UCI-Rocket-Project/rocket2-load-cell/rocket2-load-cell_render.jpg

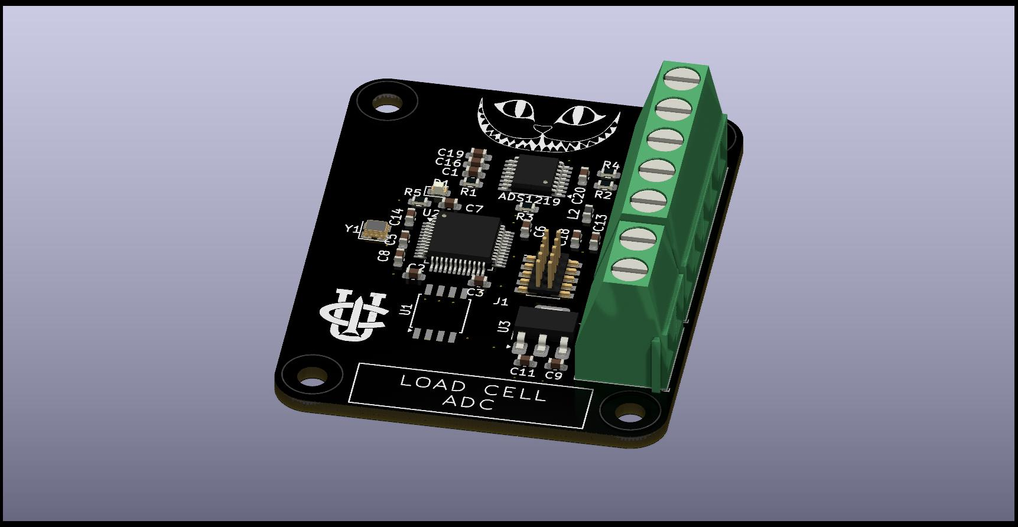
rocket2-load-cell_render.jpg
