UCI-Rocket-Project/rocket2-load-cell/topdown.png

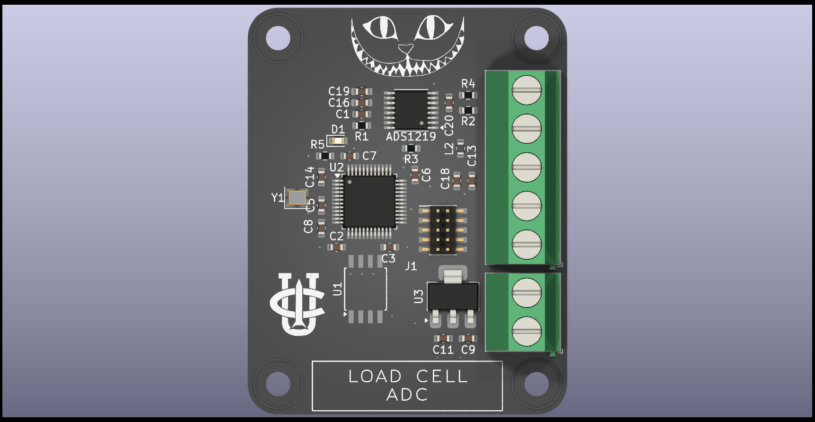
topdown.png
