UCI-Rocket-Project/rocket2-load-cell/chesirecat_image.jpg

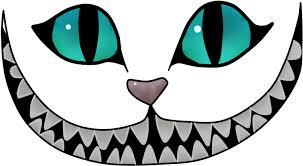
chesirecat_image.jpg
