UCI-Rocket-Project/rocket2-load-cell/side.png

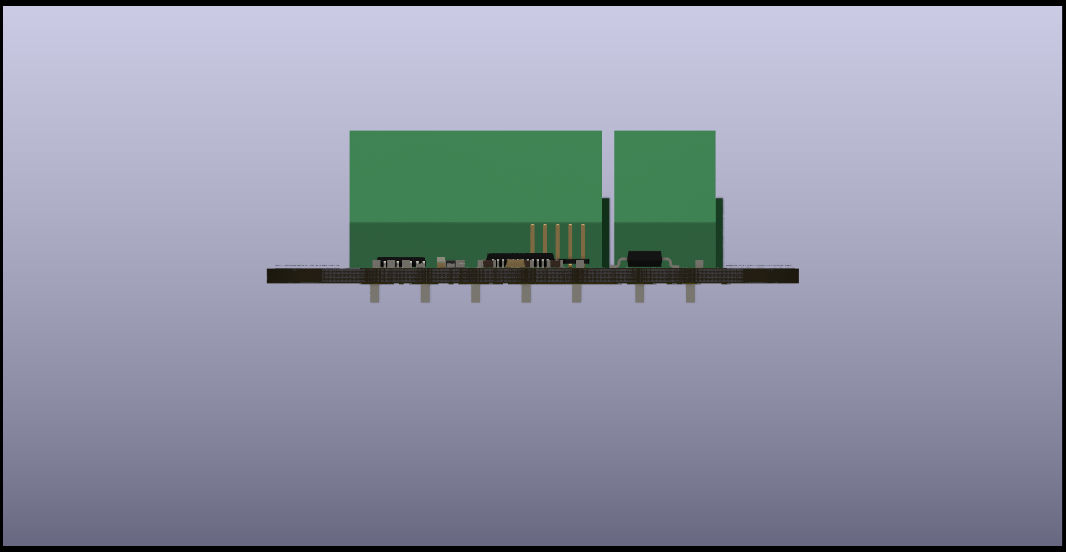
side.png
