UCI-Rocket-Project/rocket2-load-cell/3d/XPort assembly.stp

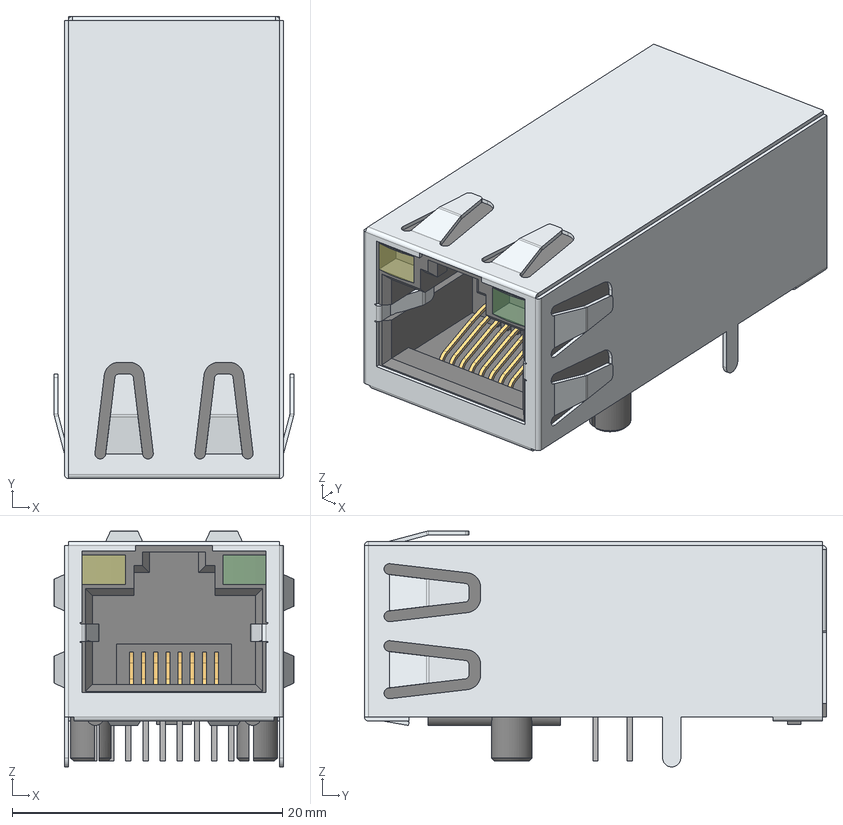
[picture p5: CAD file, 2025-01-15]
3d/XPort assembly.stp
17.7 x 34.2 x 17.5 mm
XPort Part1
XPort Part2 x 8
XPort Part6 x 9
XPort Part5
XPort part4
XPort Part3
XPort Part8
XPort Part7
