UCI-Rocket-Project/rocket2-load-cell/3d/GX12.stp

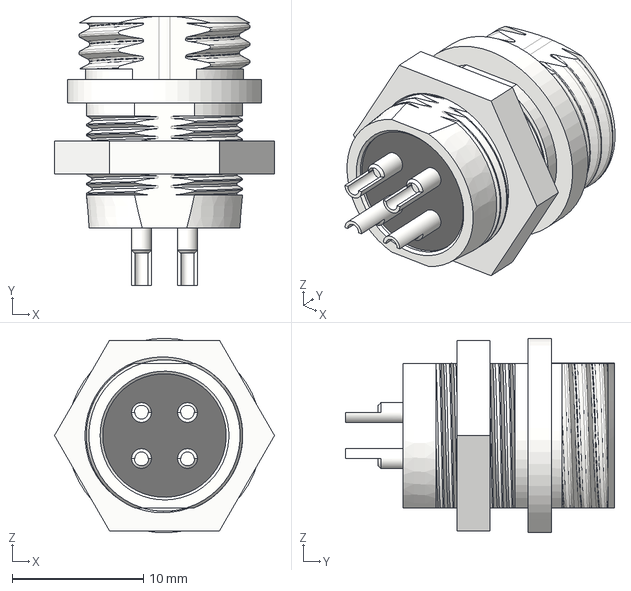
[picture p6: CAD file, 2025-01-15]
3d/GX12.stp
16.7 x 20.5 x 14.8 mm
