UCI-Rocket-Project/rocket2-load-cell/freecadpcb.FCStd

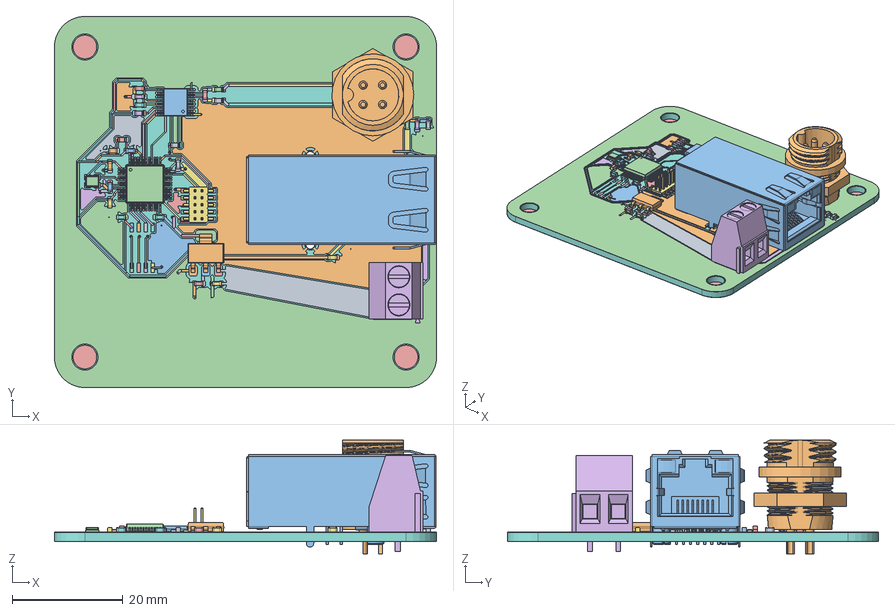
[picture p7: CAD file, 2025-05-16]
freecadpcb.FCStd
69.0 x 67.0 x 20.5 mm
R_0603_1608Metric
R_0603_1608Metric002
XPort assembly
LQFP_48_7x7mm_P05mm
C_0603_1608Metric
R_0603_1608Metric004
C_0603_1608Metric002
C_0603_1608Metric004
R_0603_1608Metric006
SOT_223
TSSOP_16_44x5mm_P065mm
Crystal_SMD_2520-4Pin_2.5x2.0mm
LED_0603_1608Metric
TerminalBlock_Phoenix_MKDS_15_2_508_1x02_P508mm_Horizontal
PinHeader_2x05_P127mm_Vertical_SMD
C_0603_1608Metric006
C_0603_1608Metric008
C_0603_1608Metric010
C_0603_1608Metric012
L_0603_1608Metric
C_0603_1608Metric014
C_0603_1608Metric016
C_0603_1608Metric018
C_0603_1608Metric020
C_0603_1608Metric022
GX12 v2
C_0603_1608Metric024
R_0603_1608Metric008
C_0603_1608Metric026
C_0603_1608Metric028
C_0603_1608Metric030
rocket2-load-cell_track_1
rocket2-load-cell_track_2
rocket2-load-cell_track_3
rocket2-load-cell_track_4
rocket2-load-cell_track_5
rocket2-load-cell_track_6
rocket2-load-cell_track_7
rocket2-load-cell_track_8
rocket2-load-cell_track_9
rocket2-load-cell_track_10
rocket2-load-cell_track_11
rocket2-load-cell_track_12
rocket2-load-cell_track_13
rocket2-load-cell_track_14
rocket2-load-cell_track_15
rocket2-load-cell_track_16
rocket2-load-cell_track_17
rocket2-load-cell_track_18
rocket2-load-cell_track_19
rocket2-load-cell_track_20
rocket2-load-cell_track_21
rocket2-load-cell_track_22
rocket2-load-cell_track_23
rocket2-load-cell_track_24
rocket2-load-cell_track_25
rocket2-load-cell_track_26
rocket2-load-cell_track_27
rocket2-load-cell_track_28
rocket2-load-cell_track_29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
