UCI-Rocket-Project/rocket2-load-cell/rocket2-load-cell.kicad_pcb

## KiCad design rocket2-load-cell.kicad_pcb (2025-05-16)

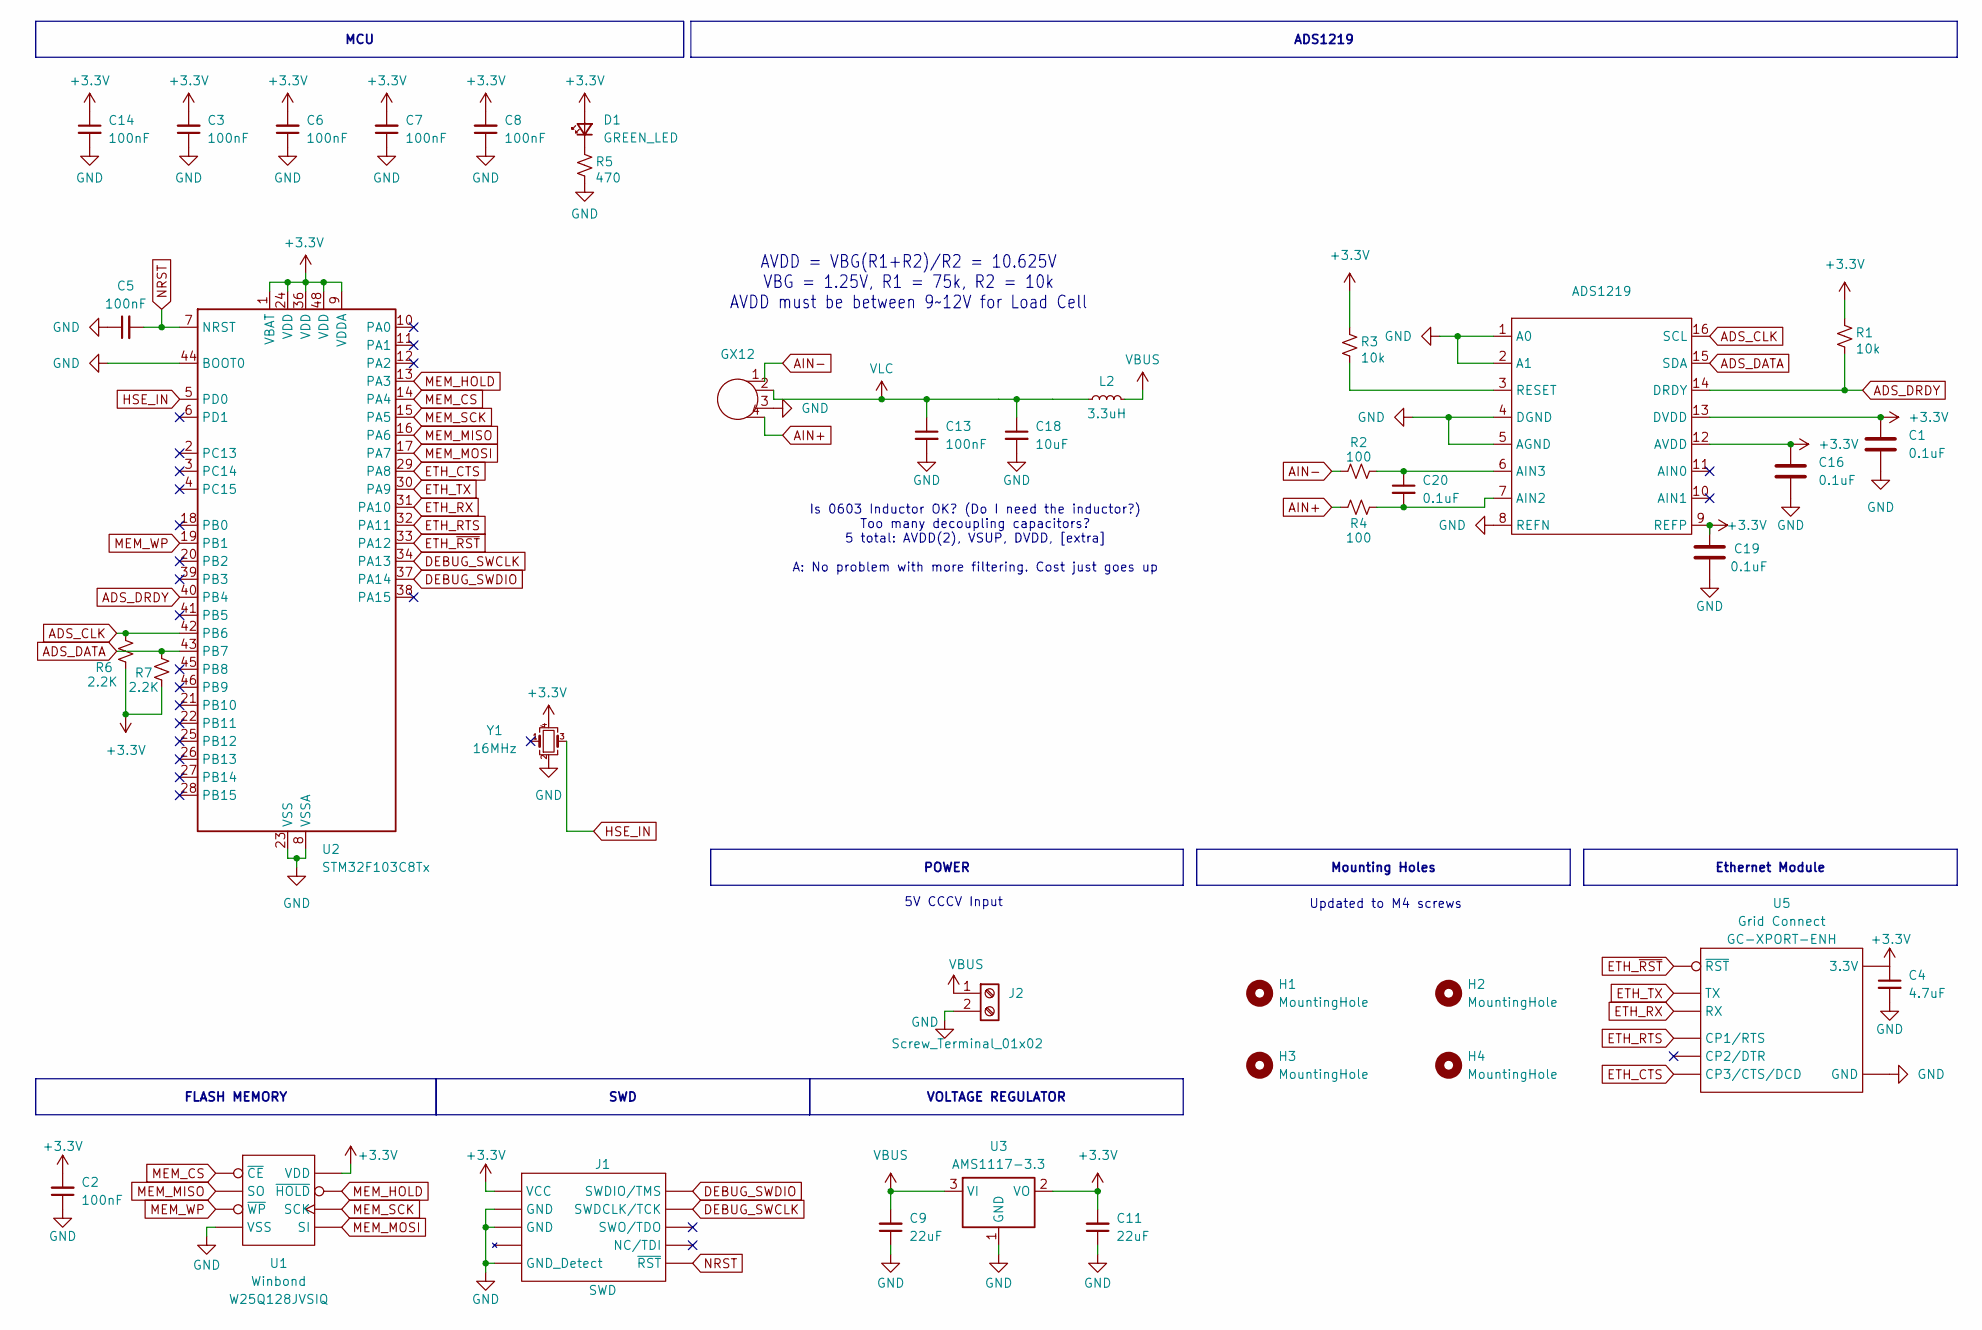
[picture p8: schematic rocket2-load-cell.kicad_sch]

Parts:
ADS1219: TSSOP-16_4.4x5mm_P0.65mm
C1, C20: 0.1uF; C_0603_1608Metric
C2, C3, C5, C6, C7, C8, C13, C14: 100nF; C_0603_1608Metric
C4: 4.7uF; C_0603_1608Metric; Part # Generic 4.7uF 6.3V X7R 0603 MLCC
C9, C11: 22uF; C_0603_1608Metric
C16, C19: 0.1uF; C_0603_1608Metric_Pad1.08x0.95mm_HandSolder
C18: 10uF; C_0603_1608Metric
D1: GREEN_LED; LED_0603_1608Metric
GX12: gx12
H1, H2, H3, H4: MountingHole; MountingHole_4.3mm_M4
J1: SWD; PinHeader_2x05_P1.27mm_Vertical_SMD; Part # Generic 2x05 P1.27mm Vertical Pin Heade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
J2: Screw_Terminal_01x02; TerminalBlock_Phoenix_MKDS-1,5-2-5.08_1x02_P5.08mm_Horizont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
L2: 3.3uH; L_0603_1608Metric
R1, R3: 10k; R_0603_1608Metric
R2, R4: 100; R_0603_1608Metric
R5: 470; R_0603_1608Metric
R6, R7: 2.2K; R_0603_1608Metric
U1: SOIC-8W_5.3x5.3mm_P1.27mm; Part # W25Q128JVSIQ
U2: STM32F103C8Tx; LQFP-48_7x7mm_P0.5mm
U3: AMS1117-3.3; SOT-223-3_TabPin2
U5: GC-XPORT; Part # GC-XPORT-ENH
Y1: 16MHz; Crystal_SMD_2520-4Pin_2.5x2.0mm; Part # ECS-1633-160-BN-TR

Connections:
+3.3V: ADS1219.9 (REFP), ADS1219.12 (AVDD), ADS1219.13 (DVDD), C1.1, C2.2, C3.2, C4.1, C6.2, C7.2, C8.2, C11.2, C14.1, C16.1, C19.1, D1.2 (A), J1.1 (VCC), R1.2, R3.2, R6.1, R7.1, U1.8 (VDD), U2.1 (VBAT), U2.9 (VDDA), U2.24 (VDD), U2.36 (VDD), U2.48 (VDD), U3.2 (VO), U5.2 (3.3V), Y1.4
ADS_CLK: ADS1219.16 (SCL), R6.2, U2.42 (PB6)
ADS_DATA: ADS1219.15 (SDA), R7.2, U2.43 (PB7)
ADS_DRDY: ADS1219.14 (DRDY), R1.1, U2.40 (PB4)
AIN+: GX12.4, R4.1
AIN-: GX12.1, R2.1
DEBUG_SWCLK: J1.4 (SWDCLK/TCK), U2.34 (PA13)
DEBUG_SWDIO: J1.2 (SWDIO/TMS), U2.37 (PA14)
ETH_CTS: U2.29 (PA8), U5.8 (CP3/CTS/DCD)
ETH_RTS: U2.32 (PA11), U5.6 (CP1/RTS)
ETH_RX: U2.31 (PA10), U5.5 (RX)
ETH_TX: U2.30 (PA9), U5.4 (TX)
ETH_~RST: U2.33 (PA12), U5.3 (~RST)
GND: ADS1219.1 (A0), ADS1219.2 (A1), ADS1219.4 (DGND), ADS1219.5 (AGND), ADS1219.8 (REFN), C1.2, C2.1, C3.1, C4.2, C5.1, C6.1, C7.1, C8.1, C9.1, C11.1, C13.2, C14.2, C16.2, C18.2, C19.2, GX12.3, J1.3 (GND), J1.5 (GND), J1.9 (GND_Detect), J2.2, R5.1, U1.4 (VSS), U2.8 (VSSA), U2.23 (VSS), U2.35 (VSS), U2.44 (BOOT0), U2.47 (VSS), U3.1 (GND), U5.1 (GND), Y1.2
HSE_IN: U2.5 (PD0), Y1.3
MEM_CS: U1.1 (~CE), U2.14 (PA4)
MEM_HOLD: U1.7 (~HOLD), U2.13 (PA3)
MEM_MISO: U1.2 (SO), U2.16 (PA6)
MEM_MOSI: U1.5 (SI), U2.17 (PA7)
MEM_SCK: U1.6 (SCK), U2.15 (PA5)
MEM_WP: U1.3 (~WP), U2.19 (PB1)
NRST: C5.2, J1.10 (~RST), U2.7 (NRST)
unnamed: ADS1219.7 (AIN2), C20.2, R4.2
unnamed: ADS1219.6 (AIN3), C20.1, R2.2
unnamed: ADS1219.3 (RESET), R3.1
unnamed: D1.1 (K), R5.2
VBUS: C9.2, J2.1, L2.2, U3.3 (VI)
VLC: C13.1, C18.1, GX12.2, L2.1

Notes on the sheet:
FLASH MEMORY
POWER
VOLTAGE REGULATOR
Mounting Holes
SWD
Ethernet Module
ADS1219
MCU
Updated to M4 screws
AVDD = VBG(R1+R2)/R2 = 10.625V VBG = 1.25V, R1 = 75k, R2 = 10k AVDD must be between 9~12V for Load Cell
5V CCCV Input
Is 0603 Inductor OK? (Do I need the inductor?) Too many decoupling capacitors? 5 total: AVDD(2), VSUP, DVDD, [extra] A: No problem with more filtering. Cost just goes up

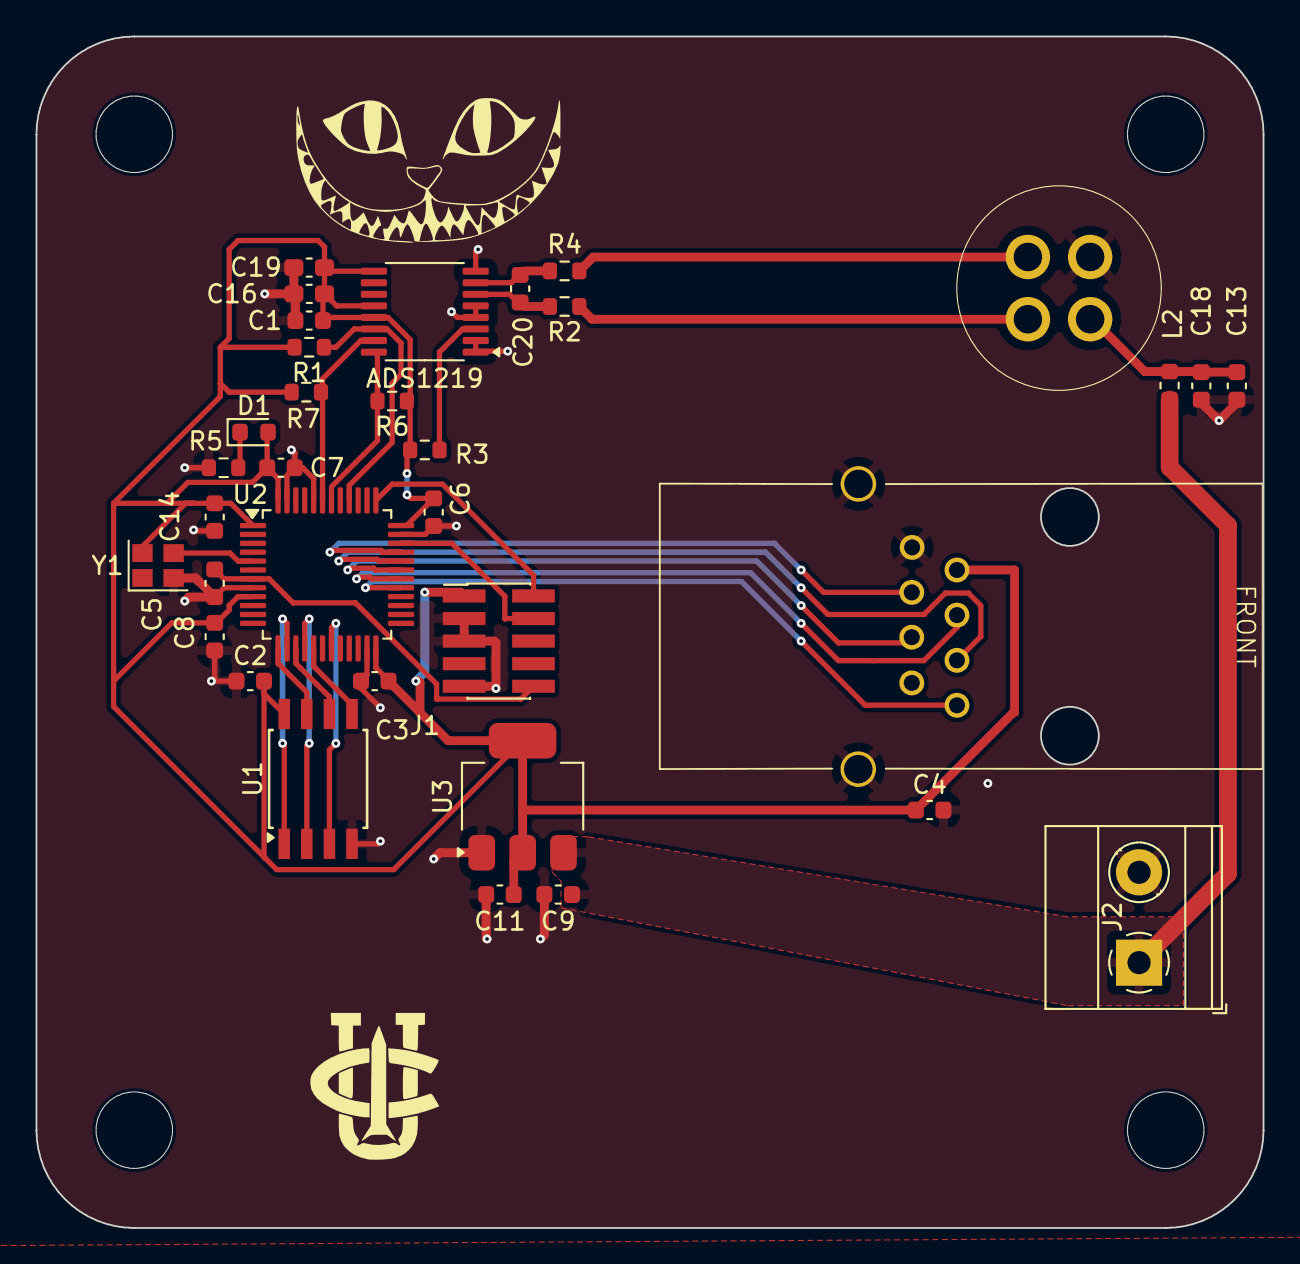
[picture p9: board rocket2-load-cell.kicad_pcb from above]

Board: 2 copper layers, 69.0 x 67.0 mm, 38 parts (0 on the bottom side), 28 nets.
