UCI-Rocket-Project/rocket2-load-cell/(threads)

Thread 1 (2024-12-17):

Load Cell Schematic+PCB Comments (Commit c5fcc33)

cadguyen, 2024-12-17:
### M3 → M4 Screw
- to keep standardized, we use M4 mounting holes for AFS and GSE

### Ethernet Module
- Load cell board should capability to communicate directly to GUI
- GSE has an ethernet module that converts I2C into ethernet, so you can reference that

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
_From GSE schematic_

### Screw Terminal (JP1) → GX16 Connector
- Load cell board should have ease of attaching to actual load cell via 4-pin GX16 connector

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
Source: https://github.com/UCI-Rocket-Project/rocket2-overview

### Load Cell Pinout
- E+ and E- should be the power supply for the load cell
- A+ and A- should be the output signal from the load cell
(Might’ve been one of my prior oversights, oopsie)

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
_E+/- and A+/- should be swapped_

### Run ERC to fix Schematic
- ADS_RESET not used
- No need to worry about power flags, though!

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
ADS_RESET not used in circuit (from ERC)

### +3.3V/GND fill on Front Layer
- Having GND fill is good for signal integrity, generally
- Having +3.3V can simplify the routing. There’s a lot of +3.3V traces, but they can be all connected by having a fill that’s connected to +3.3V

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
_Get rid of the +3.3V by using a +3.3V copper pour (fill)_

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
_Have a GND fill on the front layer_

DanielHeEGG, 2024-12-20:
The 3V3 lines are fine, keeps the cost down with only 2 layers. Do a ground pour on the top layer tho.
