UCI-Rocket-Project/rocket2-load-cell/code/load_cell_code/Core/Src/main.c

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
/* Includes ------------------------------------------------------------------*/
#include "main.h"
#include <string.h>
#include <stdbool.h>
// ADS1219 I²C address (7-bit <<1 for HAL)
#define ADS1219_I2C_ADDR        (0x40 <<1)

// ADS1219 command codes:
#define ADS1219_CMD_RESET       0x06  // soft reset
#define ADS1219_CMD_START_SYNC  0x08  // start (sync) conversion
#define ADS1219_CMD_READ_DATA   0x10  // read 3 data bytes
#define ADS1219_CMD_STATUS_READ   0x24
#define ADS1219_CMD_WRITE_CONFIG 0x40


// Our 7-byte packet: 4-byte timestamp + 3-byte ADC reading, no padding
#pragma pack(push,1)
typedef struct {
  uint32_t timestamp;
  uint8_t  adc24[3];
} DataPacket;
#pragma pack(pop)
#define SYNC0 0xAA
#define SYNC1 0x55

// Lantronix XPort reset on PA11
#define XPORT_RST_GPIO_Port   GPIOA
#define XPORT_RST_Pin         GPIO_PIN_12
/* USER CODE END Includes */
/* USER CODE END Includes */

I2C_HandleTypeDef hi2c1;

SPI_HandleTypeDef hspi1;

UART_HandleTypeDef  huart1;

/* USER CODE BEGIN PV */
static DataPacket txPacket;

/* USER CODE END PV */

void SystemClock_Config(void);
static void MX_GPIO_Init(void);
static void MX_I2C1_Init(void);
static void MX_SPI1_Init(void);
static void MX_UART1_Init(void);
/* USER CODE BEGIN PFP */
static int32_t ADS1219_ReadRaw(void);
static bool     ADS1219_dataReady(void);
static int32_t  ADS1219_readConversion(void);


/* USER CODE END PFP */

/* USER CODE BEGIN 0 */
/* USER CODE BEGIN 0 */
static int32_t ADS1219_ReadRaw(void)
{
    uint8_t cmd, raw[3];
    uint32_t u;

    // 1) START_SYNC
    cmd = ADS1219_CMD_START_SYNC;
    HAL_StatusTypeDef check =  HAL_I2C_Master_Transmit(&hi2c1, ADS1219_I2C_ADDR, &cmd, 1, 100);


    // 2) wait for DRDY on PB4 (active low)
    while (HAL_GPIO_ReadPin(GPIOB, GPIO_PIN_4) == GPIO_PIN_SET) { }

    // 3) READ_DATA + fetch 3 bytes
    cmd = ADS1219_CMD_READ_DATA;
    HAL_I2C_Master_Transmit(&hi2c1, ADS1219_I2C_ADDR, &cmd, 1, 100);
    HAL_I2C_Master_Receive(&hi2c1, ADS1219_I2C_ADDR, raw, 3, 100);

    // 4) assemble signed 24→32-bit
    u = ((uint32_t)raw[0] << 16) |
        ((uint32_t)raw[1] <<  8) |
         (uint32_t)raw[2];
    if (u & 0x00800000) u |= 0xFF000000;  // sign-extend
    return (int32_t)u;
}
// Returns true once the ADS1219’s DRDY bit (bit7 of status reg) is set
static bool ADS1219_dataReady(void)
{
    uint8_t cmd = ADS1219_CMD_STATUS_READ;
    uint8_t status = 0;

    HAL_StatusTypeDef check = HAL_I2C_Master_Transmit(&hi2c1, ADS1219_I2C_ADDR, &cmd, 1, 100);


    if ( check != HAL_OK)
        return false;
    check = HAL_I2C_Master_Receive(&hi2c1, ADS1219_I2C_ADDR, &status, 1, 100);

    if (check != HAL_OK)
        return false;

    return (status & 0x80) != 0;
}

// Reads 3 bytes via the “read data” command, sign-extends to 32 bits
static int32_t ADS1219_readConversion(void)
{
    uint8_t cmd = ADS1219_CMD_READ_DATA;
    uint8_t raw[3];
    uint32_t u = 0;

    HAL_I2C_Master_Transmit(&hi2c1, ADS1219_I2C_ADDR, &cmd, 1, 100);
    HAL_I2C_Master_Receive (&hi2c1, ADS1219_I2C_ADDR, raw, 3, 100);

    u = ((uint32_t)raw[0] << 16) |
        ((uint32_t)raw[1] <<  8) |
         (uint32_t)raw[2];

    // sign-extend 24→32 bits
    if (u & 0x00800000)
        u |= 0xFF000000;

    return (int32_t)u;
}

/* USER CODE END 0 */


/* USER CODE END 0 */

/**
  * @brief  The application entry point.
  * @retval int
  */
int main(void)
{

  /* MCU Configuration--------------------------------------------------------*/

  /* Reset of all peripherals, Initializes the Flash interface and the Systick. */
  HAL_Init();

  /* Configure the system clock */
  SystemClock_Config();

  /* Initialize all configured peripherals */
  MX_GPIO_Init();
  MX_I2C1_Init();
  MX_SPI1_Init();
  MX_UART1_Init();
  /* USER CODE BEGIN 2 */
  // reset ads1219 following arduino library

  {
    uint8_t cmd = ADS1219_CMD_RESET;
    HAL_StatusTypeDef check = HAL_I2C_Master_Transmit(&hi2c1, ADS1219_I2C_ADDR, &cmd, 1, 100);
    HAL_Delay(1);  // tRSSTA ≥100 µs
  }
  {
    uint8_t config[] = {
      ADS1219_CMD_WRITE_CONFIG,
      0x2C
    };
    uint8_t hdr[2] = { SYNC0, SYNC1 };
    HAL_UART_Transmit(&huart1, hdr, 2, 10);
    HAL_I2C_Master_Transmit(&hi2c1, ADS1219_I2C_ADDR, config, 2, 100);
  }


  // Reset the Lantronix XPort on PA11
  HAL_GPIO_WritePin(XPORT_RST_GPIO_Port, XPORT_RST_Pin, GPIO_PIN_RESET);
  HAL_Delay(10);   // hold reset low ≥10 ms
  HAL_GPIO_WritePin(XPORT_RST_GPIO_Port, XPORT_RST_Pin, GPIO_PIN_SET);
  HAL_Delay(800);
  /* USER CODE END 2 */

  /* Infinite loop */
  /* USER CODE BEGIN WHILE */
  while (1)
  {
    /* USER CODE END WHILE */
	  /* USER CODE BEGIN 3 */
	    // 1) timestamp
	    txPacket.timestamp = HAL_GetTick();

	    // 2) trigger a conversion
	    {
	      uint8_t cmd = ADS1219_CMD_START_SYNC;
	      HAL_StatusTypeDef check = HAL_I2C_Master_Transmit(&hi2c1, ADS1219_I2C_ADDR, &cmd, 1, 100);
	      HAL_Delay(1);  // tRSSTA ≥100 µs
	    }

	    // 3) wait until the library‐style dataReady() returns true
	    while (!ADS1219_dataReady());

	    // 4) fetch & pack the signed 24-bit result
	    {
	      int32_t raw = ADS1219_readConversion();
	      txPacket.adc24[0] = (raw >> 16) & 0xFF;
	      txPacket.adc24[1] = (raw >>  8) & 0xFF;
	      txPacket.adc24[2] = (raw      ) & 0xFF;
	    }

	    // 5) send your 7-byte packet over UART1 → XPort
	    HAL_UART_Transmit(&huart1,
	                      (uint8_t *)&txPacket,
	                      sizeof(txPacket),
	                      100);
//	  /* USER CODE END 3 */

  }
  /* USER CODE END 3 */
}

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
