UCI-Rocket-Project/rocket2-load-cell/code/load_cell_code/code.ioc

Mcu.UserName=STM32F103C8Tx
PA10.Signal=USART1_RX
PA12.Signal=GPIO_Output
PA13.Signal=SYS_JTMS-SWDIO
PA14.Signal=SYS_JTCK-SWCLK
PA3.Signal=GPIO_Output
PA4.Signal=SPI1_NSS
PA5.Signal=SPI1_SCK
PA6.Signal=SPI1_MISO
PA7.Signal=SPI1_MOSI
PA9.Signal=USART1_TX
PB1.Signal=GPIO_Output
PB4.Signal=GPIO_Input
PB6.Signal=I2C1_SCL
PB7.Signal=I2C1_SDA
