UCI-Rocket-Project/rocket2-load-cell/(commit log)

2024-09-28 Imported UCIRP KiCad template files
    [rocket2-load-cell.kicad_pcb, rocket2-load-cell.kicad_sch]
2024-10-07 David's Schematic
    [rocket2-load-cell.kicad_sch]
2024-10-07 HSE Crystal (16MHz) and Adjusted AVDD (10.625V)
    [rocket2-load-cell.kicad_sch]
2024-10-08 Changed to small components. Added +5V power supply
    [rocket2-load-cell.kicad_sch]
2024-10-08 Tidied up schematic, added comments for Daniel
    [rocket2-load-cell.kicad_sch]
2024-10-08 Resolved comments. Need new amplifier for faster sampling.
    [rocket2-load-cell.kicad_sch]
2024-10-08 Load cell E+ +3.3 -> +5V
    [rocket2-load-cell.kicad_sch]
2024-11-21 added working arduino code as well as testread.py(nonop)
    [rocket2-load-cell.kicad_pcb, rocket2-load-cell.kicad_sch]
2024-12-01 added final scaling changed and print debugging
2024-12-03 finished routing file(submit for review)
    [rocket2-load-cell.kicad_pcb, rocket2-load-cell.kicad_sch]
2024-12-03 submitting for review
    [rocket2-load-cell.kicad_pcb, rocket2-load-cell.kicad_sch]
2024-12-03 Revert "submitting for review"
    This reverts commit 1e17fc2b929a1369e5cebb95b8d17141503d9833.
    accidentaly deleted schematic...
    [rocket2-load-cell.kicad_pcb, rocket2-load-cell.kicad_sch]
2024-12-03 Revert "finished routing file(submit for review)"
    This reverts commit a7b270876cc0567c9db231a326dac314d918e378.
    [rocket2-load-cell.kicad_pcb, rocket2-load-cell.kicad_sch]
2024-12-03 fixed back up issue
    [rocket2-load-cell.kicad_pcb, rocket2-load-cell.kicad_sch]
2024-12-03 added images and made it coooooooooooooollllllllllllllllllllllllllllllllllllllllllllllllllll
    [rocket2-load-cell.kicad_pcb]
2024-12-04 added cool images to loadcell silk screen
    [rocket2-load-cell.kicad_pcb]
2025-01-07 added ethernet module as well as fixing some wireing issues
    [rocket2-load-cell.kicad_pcb, rocket2-load-cell.kicad_sch]
2025-01-07 fixed important erc errors
    [rocket2-load-cell.kicad_sch]
2025-01-08 okay final final change this time, also added fabrication files
    [rocket2-load-cell-B_Cu.gbr, rocket2-load-cell-B_Mask.gbr, rocket2-load-cell-B_Paste.gbr, rocket2-load-cell-B_Silkscreen.gbr, rocket2-load-cell-Edge_Cuts.gbr, rocket2-load-cell-F_Cu.gbr, rocket2-load-cell-F_Mask.gbr, rocket2-load-cell-F_Paste.gbr]
2025-01-09 made it so that all vias are connected, should be good for fabrication, no design errors now
    [rocket2-load-cell-B_Cu.gbr, rocket2-load-cell-B_Mask.gbr, rocket2-load-cell-B_Paste.gbr, rocket2-load-cell-B_Silkscreen.gbr, rocket2-load-cell-Edge_Cuts.gbr, rocket2-load-cell-F_Cu.gbr, rocket2-load-cell-F_Mask.gbr, rocket2-load-cell-F_Paste.gbr]
2025-01-15 added gx12 connector and fixed varioius other design problems
    [rocket2-load-cell-B_Cu.gbr, rocket2-load-cell-B_Mask.gbr, rocket2-load-cell-B_Paste.gbr, rocket2-load-cell-B_Silkscreen.gbr, rocket2-load-cell-Edge_Cuts.gbr, rocket2-load-cell-F_Cu.gbr, rocket2-load-cell-F_Mask.gbr, rocket2-load-cell-F_Paste.gbr]
2025-01-15 added cad models to board
    [GX12.stp, XPort assembly.stp, rocket2-load-cell.kicad_sch]
2025-01-15 changed via locations
    [rocket2-load-cell.kicad_pcb]
2025-01-15 cleaned up vias once again removed redundant tracks
    [rocket2-load-cell.kicad_pcb]
2025-01-15 moved gx12 futher from ethernet
    [rocket2-load-cell.kicad_pcb]
2025-01-27 changed back to 5v and removed 12 volt reg
    [rocket2-load-cell.kicad_pcb, rocket2-load-cell.kicad_sch]
2025-04-24 added stm32 prroject
2025-05-16 added code and stab
    [freecadpcb.FCStd, rocket2-load-cell.kicad_pcb, rocket2-load-cell.kicad_sch]
2025-05-17 changed code
    [loadcelldata.csv]
