UCI-Rocket-Project/rocket2-load-cell/(notices)

Notices in the files:
code/load_cell_code/Core/Src/main.c:
Copyright (c) 2025 STMicroelectronics.
All rights reserved.
This software is licensed under terms that can be found in the LICENSE file
